hisea/keyboards/Pro_wireless/Case/Lily58_Pro_BOTTOM.dxf

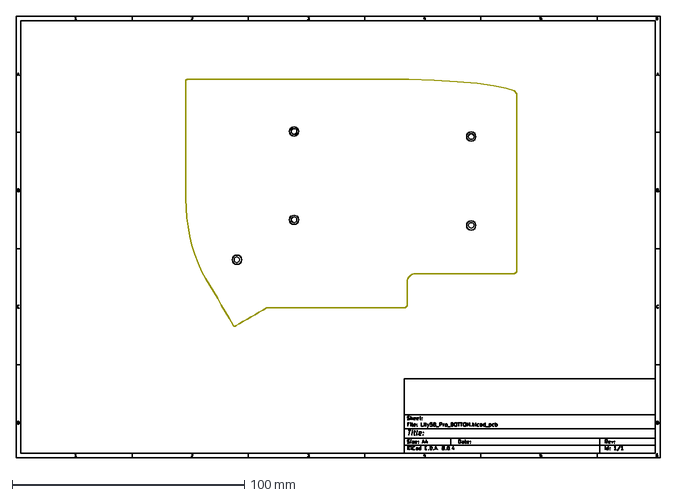
[picture p1: CAD file, 2024-12-01]
Pro_wireless/Case/Lily58_Pro_BOTTOM.dxf
277.0 x 190.0 mm
