hisea/keyboards/Pro_wireless/PCB/Lily58_Pro.kicad_pcb

## KiCad design Pro_wireless/PCB/Lily58_Pro.kicad_pcb (2024-12-01)

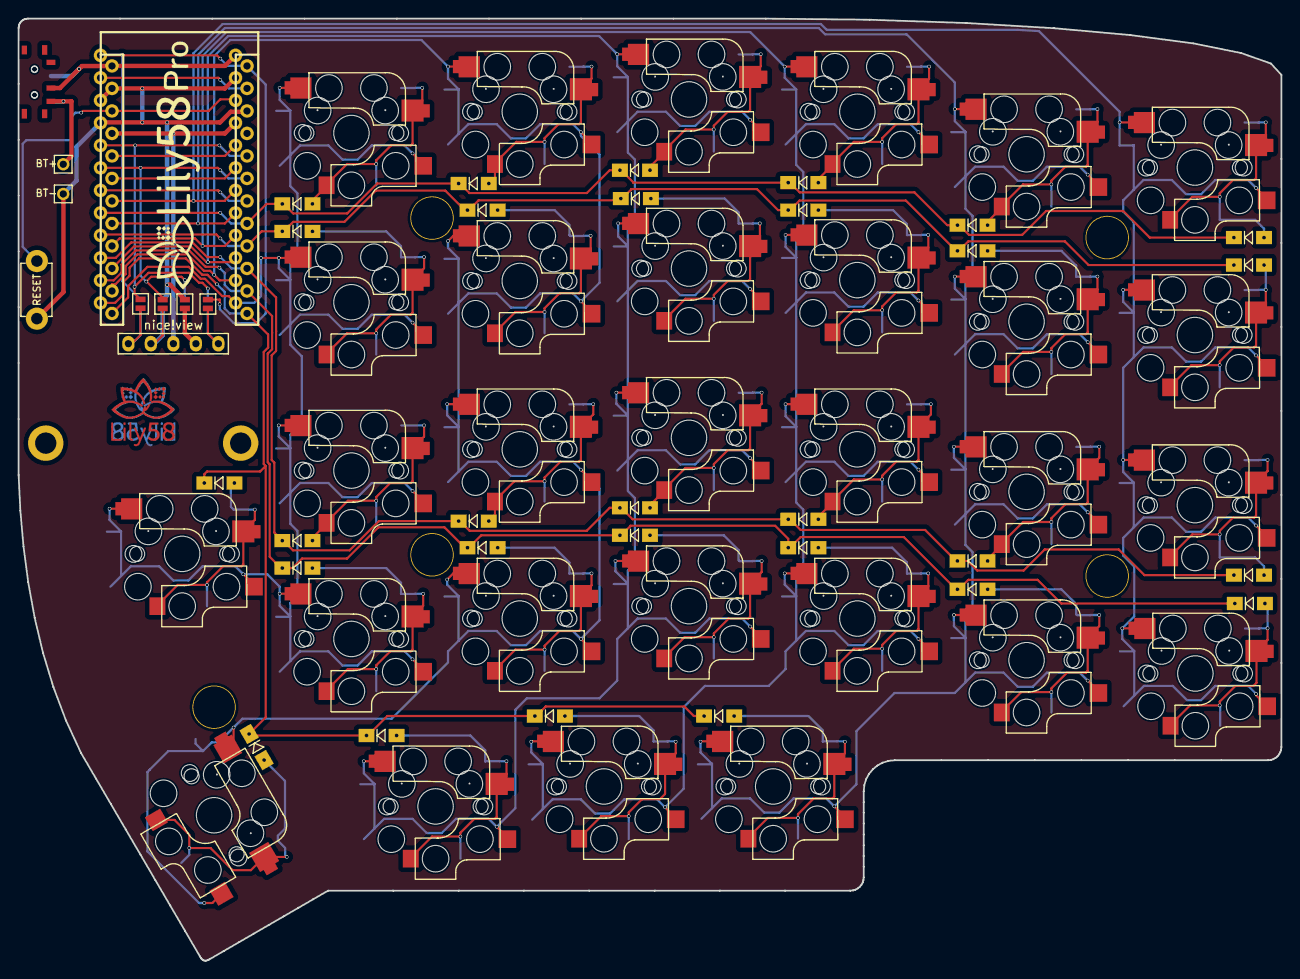
[picture p2: board Lily58_Pro.kicad_pcb from above]

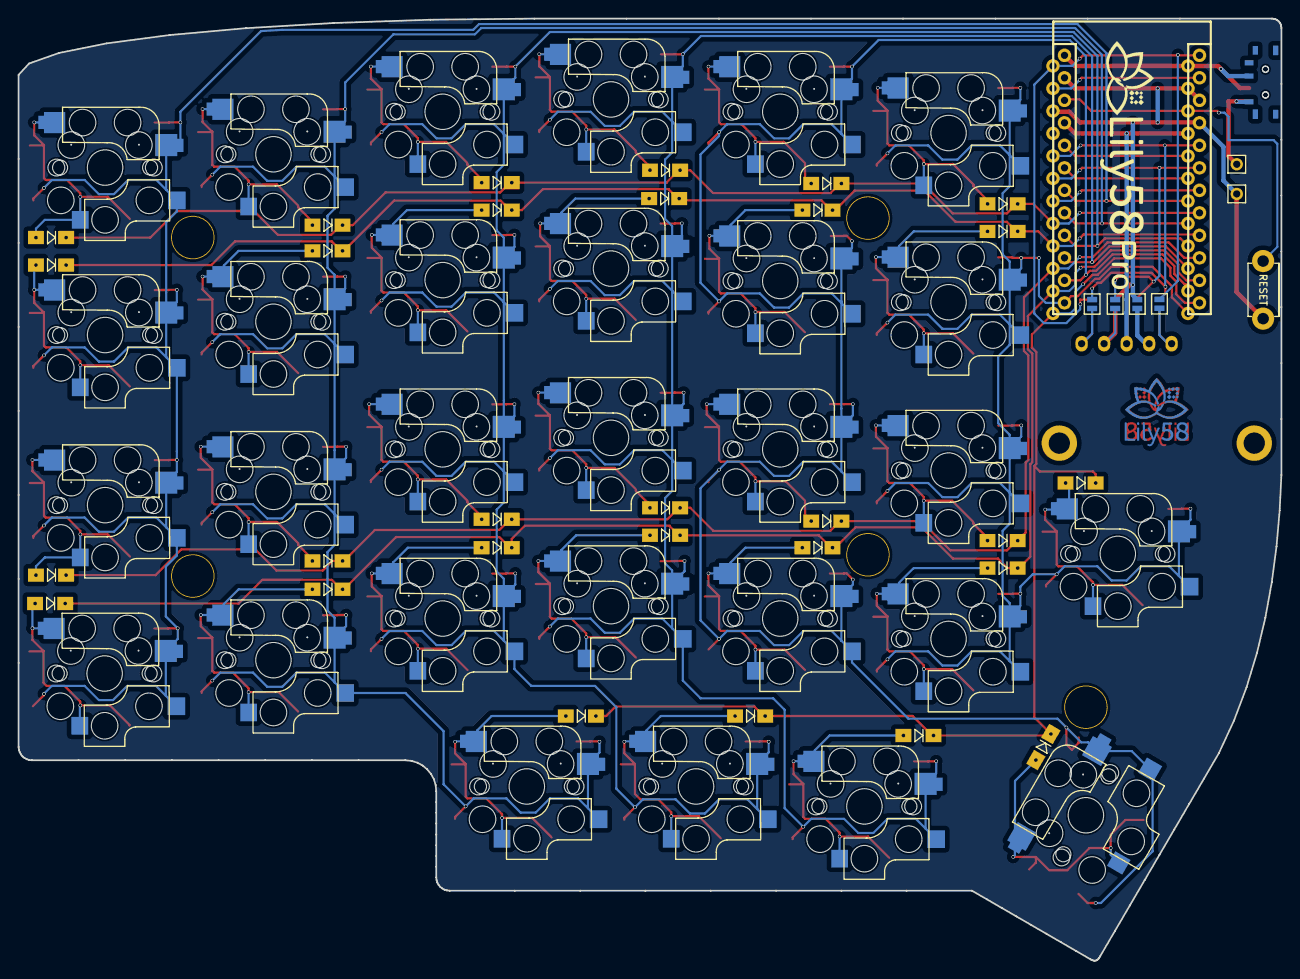
[picture p3: board Lily58_Pro.kicad_pcb from below]

Board: 2 copper layers, 142.5 x 106.3 mm, 80 parts (5 on the bottom side), 23 nets.

Parts:
BT+: BATT+; 1pin_conn
BT-: BATT_GND; 1pin_conn
D1, D2, D3, D4, D5, D6, D7, D8, D9, D10, D11, D12, D13, D14, D15, D16, D17, D18, D19, D20, D21, D22, D23, D24, D25, D26, D27, D28, D29: D; Diode_SOD123
Display1: nice!view; nice_view_1side
JP1, JP2, JP3, JP4, JP5, JP6, JP7, JP8: Jumper
PWSW1, PWSW2: SW_SPDT_312; switch-MSK-12C02-smd
RSW1: SW_RST; TACT_SWITCH_TVBP06
SW1, SW2, SW3, SW4, SW5, SW6, SW7, SW8, SW9, SW10, SW11, SW12, SW13, SW14, SW15, SW16, SW17, SW18, SW19, SW20, SW21, SW22, SW23, SW24, SW25, SW26, SW27, SW28, SW29: SW_PUSH; CherryMX_KailhLowProfile_Hotswap_edge
TH1, TH2: HOLE; M2_HOLE_PCB
TH3, TH4, TH5, TH6, TH7: HOLE; HOLE_M2_TH
U1: ProMicro; ProMicro_rev2

Connections:
BATT+: PWSW1.2 (C), PWSW2.2 (C), U1.24 (RAW)
DATA: JP1.2, JP8.2, U1.1 (TX(PD3))
GND: BT-.1, JP2.2, JP7.2, RSW1.1, U1.3 (GND), U1.4 (GND), U1.23 (GND)
unnamed: Display1.5 (CS), JP1.1, JP5.1
unnamed: Display1.4 (GND), JP2.1, JP6.1
unnamed: Display1.1 (MOSI), JP4.1, JP8.1
unnamed: Display1.2 (SCK), JP3.1, JP7.1
unnamed: BT+.1, PWSW1.1 (B), PWSW2.3 (A)
RESET: RSW1.2, U1.22 (RST)
SCL: JP3.2, JP6.2, U1.6 (SCL(PD0))
SDA: JP4.2, JP5.2, U1.5 (SDA(PD1))
VCC: Display1.3 (VCC), U1.21 (VCC)
col0: SW6.1, SW12.1, SW18.1, SW24.1, U1.18 (A1(PF6))
col1: SW5.1, SW11.1, SW17.1, SW23.1, SW29.1, U1.17 (A0(PF7))
col2: SW4.1, SW10.1, SW16.1, SW22.1, SW28.1, U1.16 (D15(PB1))
col3: SW3.1, SW9.1, SW15.1, SW21.1, SW27.1, U1.15 (D14(PB3))
col4: SW2.1, SW8.1, SW14.1, SW20.1, SW26.1, U1.14 (D16(PB2))
col5: SW1.1, SW7.1, SW13.1, SW19.1, SW25.1, U1.13 (D10(PB6))
row0: D1.1 (K), D2.1 (K), D3.1 (K), D4.1 (K), D5.1 (K), D6.1 (K), U1.8 (D5(PC6))
row1: D7.1 (K), D8.1 (K), D9.1 (K), D10.1 (K), D11.1 (K), D12.1 (K), U1.9 (D6(PD7))
row2: D13.1 (K), D14.1 (K), D15.1 (K), D16.1 (K), D17.1 (K), D18.1 (K), U1.10 (D7(PE6))
row3: D19.1 (K), D20.1 (K), D21.1 (K), D22.1 (K), D23.1 (K), D24.1 (K), U1.11 (D8(PB4))
row4: D25.1 (K), D26.1 (K), D27.1 (K), D28.1 (K), D29.1 (K), U1.12 (D9(PB5))
