hisea/keyboards/crkbd/corne-ultralight-flex-fixed.kicad_pcb

## KiCad design crkbd/corne-ultralight-flex-fixed.kicad_pcb (2024-09-01)

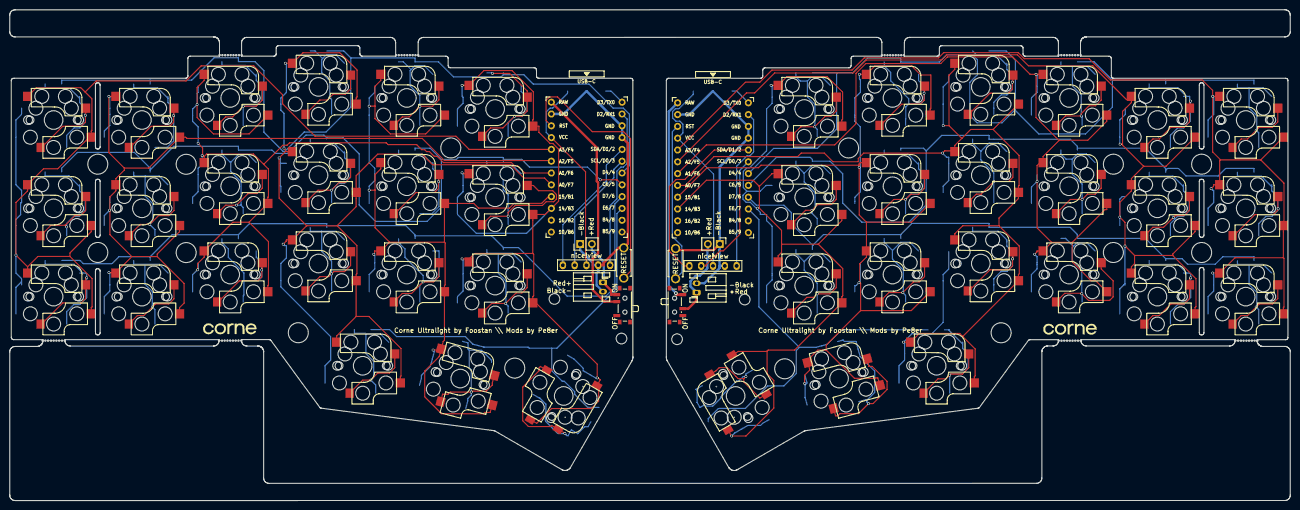
[picture p4: board corne-ultralight-flex-fixed.kicad_pcb from above]

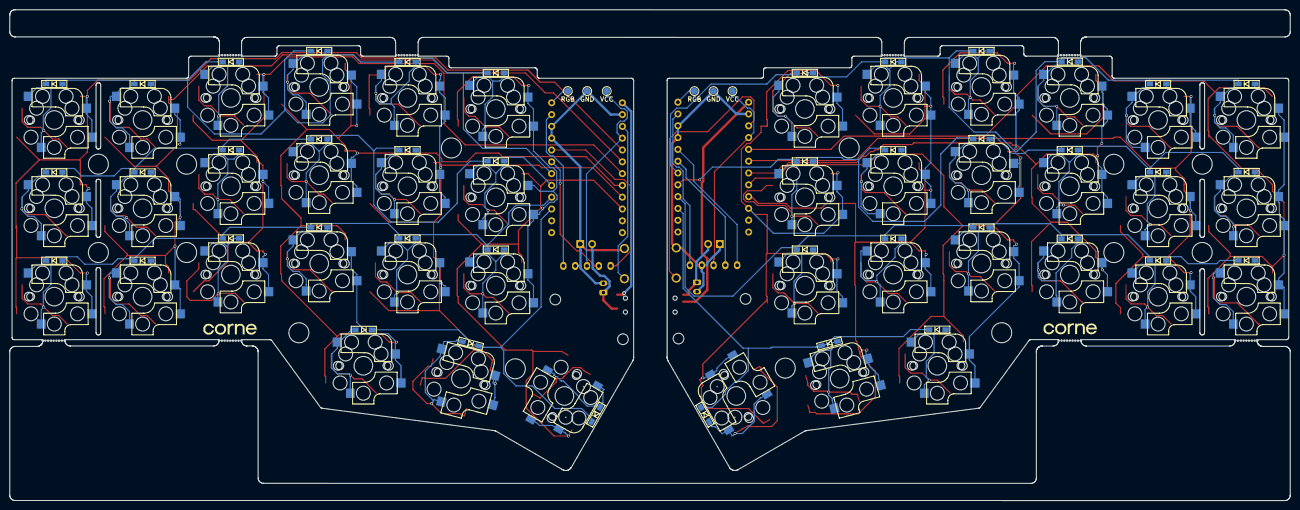
[picture p5: board corne-ultralight-flex-fixed.kicad_pcb from below]

Board: 2 copper layers, 275.5 x 105.6 mm, 132 parts (52 on the bottom side), 80 nets.

Parts:
BATJ1, BATJ3: Conn_01x02_Female; PinHeader_1x02_P2.54mm_Vertical
BATJ2, BATJ4: Conn_01x02_Female; JST_PH_S2B-PH-K_1x02_P2.00mm_Horizontal
D1, D2, D3, D4, D5, D6, D7, D8, D9, D10, D11, D12, D13, D14, D15, D16, D17, D18, D19, D20, D21, D22, D23, D24, D25, D26, D27, D28, D29, D30, D31, D32, D33, D34, D35, D36, D37, D38, D39, D40, D41, D42: D; D3_SMD_v2
GRAPHIC BR: LOGO; corne-logo-horizontal
GRAPHIC FR: LOGO; corne-logo-horizontal
Graphic BL: LOGO; corne-logo-horizontal
Graphic FL: LOGO; corne-logo-horizontal
HOLE1, HOLE2, HOLE8, HOLE9: Val**; thread_m2
HOLE3, HOLE4, HOLE5, HOLE6, HOLE7, HOLE10, HOLE11, HOLE12, HOLE13, HOLE14, HOLE15, HOLE16, HOLE17, HOLE18: Val**; spacer_m2
J1, J2, J3, J4, J5, J6, J7, J8: Breakaway_Tabs
J2.1, J2.2: OLED; nice_view_1side
PSW1, PSW2: SW_SPST; SW_SPDT_PCM12
RSW1, RSW2: SW_PUSH; ResetSW_1side
SW1, SW2, SW3, SW4, SW5, SW6, SW7, SW8, SW9, SW10, SW11, SW12, SW13, SW14, SW15, SW16, SW17, SW18, SW19, SW20, SW22, SW23, SW24, SW25, SW26, SW27, SW28, SW29, SW30, SW31, SW32, SW33, SW34, SW35, SW36, SW37, SW38, SW39, SW40, SW41: SW_PUSH; CherryMX_Choc_Hotswap
SW21, SW42: SW_PUSH; CherryMX_Choc_Hotswap_1.5u
TP1, TP4: RGB; TestPoint_Pad_D1.5mm
TP2, TP5: VCC; TestPoint_Pad_D1.5mm
TP3, TP6: GND; TestPoint_Pad_D1.5mm
U1, U2: ProMicro; ProMicro_v3

Connections:
+BATT: PSW1.2 (B), U1.24 (RAW)
+BATTA: PSW2.1 (A), U2.24 (RAW)
CS: J2.1.5, U1.2 (RX1/D2)
CS_r: J2.2.5, U2.2 (RX1/D2)
GND: BATJ1.1, BATJ2.2, J2.1.4, RSW1.2, TP3.1, U1.3 (GND), U1.4 (GND), U1.23 (GND)
GNDA: BATJ3.1, BATJ4.2, J2.2.4, RSW2.2, TP6.1, U2.3 (GND), U2.4 (GND), U2.23 (GND)
unnamed: BATJ1.2, BATJ2.1, PSW1.3 (C)
unnamed: BATJ3.2, BATJ4.1, PSW2.2 (B)
unnamed: D1.2 (A), SW1.2
unnamed: D2.2 (A), SW2.2
unnamed: D3.2 (A), SW3.2
unnamed: D4.2 (A), SW4.2
unnamed: D5.2 (A), SW5.2
unnamed: D6.2 (A), SW6.2
unnamed: D7.2 (A), SW7.2
unnamed: D8.2 (A), SW8.2
unnamed: D9.2 (A), SW9.2
unnamed: D10.2 (A), SW10.2
unnamed: D11.2 (A), SW11.2
unnamed: D12.2 (A), SW12.2
unnamed: D13.2 (A), SW13.2
unnamed: D14.2 (A), SW14.2
unnamed: D15.2 (A), SW15.2
unnamed: D16.2 (A), SW16.2
unnamed: D17.2 (A), SW17.2
unnamed: D18.2 (A), SW18.2
unnamed: D19.2 (A), SW19.2
unnamed: D20.2 (A), SW20.2
unnamed: D21.2 (A), SW21.2
unnamed: D22.2 (A), SW22.2
unnamed: D23.2 (A), SW23.2
unnamed: D24.2 (A), SW24.2
unnamed: D25.2 (A), SW25.2
unnamed: D26.2 (A), SW26.2
unnamed: D27.2 (A), SW27.2
unnamed: D28.2 (A), SW28.2
unnamed: D29.2 (A), SW29.2
unnamed: D30.2 (A), SW30.2
unnamed: D31.2 (A), SW31.2
unnamed: D32.2 (A), SW32.2
unnamed: D33.2 (A), SW33.2
unnamed: D34.2 (A), SW34.2
unnamed: D35.2 (A), SW35.2
unnamed: D36.2 (A), SW36.2
unnamed: D37.2 (A), SW37.2
unnamed: D38.2 (A), SW38.2
unnamed: D39.2 (A), SW39.2
unnamed: D40.2 (A), SW40.2
unnamed: D41.2 (A), SW41.2
unnamed: D42.2 (A), SW42.2
RGB: TP1.1, U1.1 (TX0/D3)
RGB_r: TP4.1, U2.1 (TX0/D3)
SCL: J2.1.2, U1.6 (3/D0/SCL)
SCL_r: J2.2.2, U2.6 (3/D0/SCL)
SDA: J2.1.1, U1.5 (2/D1/SDA)
SDA_r: J2.2.1, U2.5 (2/D1/SDA)
VCC: J2.1.3, TP2.1, U1.21 (VCC)
VDD: J2.2.3, TP5.1, U2.21 (VCC)
col0: SW1.1, SW7.1, SW13.1, U1.20 (F4/A3)
col0_r: SW22.1, SW28.1, SW34.1, U2.20 (F4/A3)
col1: SW2.1, SW8.1, SW14.1, U1.19 (F5/A2)
col1_r: SW23.1, SW29.1, SW35.1, U2.19 (F5/A2)
col2: SW3.1, SW9.1, SW15.1, U1.18 (F6/A1)
col2_r: SW24.1, SW30.1, SW36.1, U2.18 (F6/A1)
col3: SW4.1, SW10.1, SW16.1, SW19.1, U1.17 (F7/A0)
col3_r: SW25.1, SW31.1, SW37.1, SW40.1, U2.17 (F7/A0)
col4: SW5.1, SW11.1, SW17.1, SW20.1, U1.16 (B1/15)
col4_r: SW26.1, SW32.1, SW38.1, SW41.1, U2.16 (B1/15)
col5: SW6.1, SW12.1, SW18.1, SW21.1, U1.15 (B3/14)
col5_r: SW27.1, SW33.1, SW39.1, SW42.1, U2.15 (B3/14)
reset: RSW1.1, U1.22 (RST)
reset_r: RSW2.1, U2.22 (RST)
row0: D1.1 (K), D2.1 (K), D3.1 (K), D4.1 (K), D5.1 (K), D6.1 (K), U1.7 (4/D4)
row0_r: D22.1 (K), D23.1 (K), D24.1 (K), D25.1 (K), D26.1 (K), D27.1 (K), U2.7 (4/D4)
row1: D7.1 (K), D8.1 (K), D9.1 (K), D10.1 (K), D11.1 (K), D12.1 (K), U1.8 (5/C6)
row1_r: D28.1 (K), D29.1 (K), D30.1 (K), D31.1 (K), D32.1 (K), D33.1 (K), U2.8 (5/C6)
row2: D13.1 (K), D14.1 (K), D15.1 (K), D16.1 (K), D17.1 (K), D18.1 (K), U1.9 (6/D7)
row2_r: D34.1 (K), D35.1 (K), D36.1 (K), D37.1 (K), D38.1 (K), D39.1 (K), U2.9 (6/D7)
row3: D19.1 (K), D20.1 (K), D21.1 (K), U1.10 (7/E6)
row3_r: D40.1 (K), D41.1 (K), D42.1 (K), U2.10 (7/E6)
